martinhansdk/USB-epaper-thing/electronics/E-paper adapter board/E-paper adapter board.step

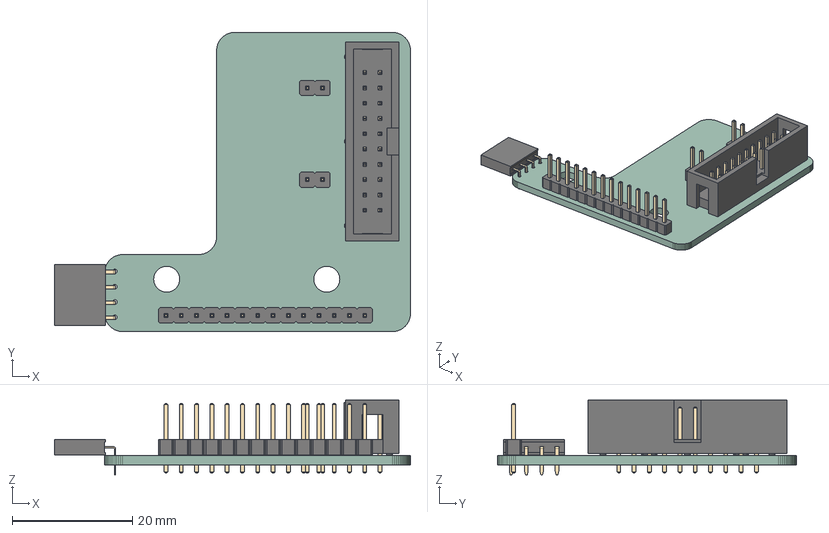
[picture p1: CAD file, 2023-12-19]
electronics/E-paper adapter board/E-paper adapter board.step
59.1 x 49.7 x 12.4 mm
_autosave-E-paper adapter board PCB
