martinhansdk/USB-epaper-thing/electronics/USB E-Paper thing/USB E-Paper thing.kicad_pcb

## KiCad design electronics/USB E-Paper thing/USB E-Paper thing.kicad_pcb (2023-12-19)

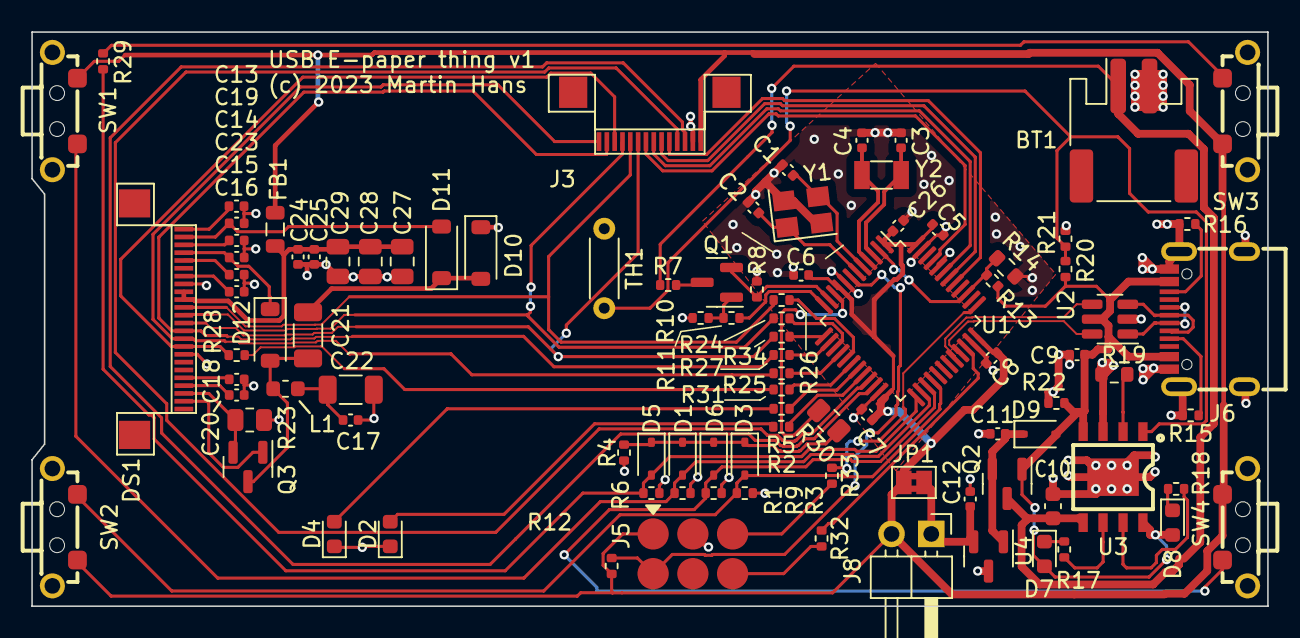
[picture p2: board USB E-Paper thing.kicad_pcb from above]

Board: 2 copper layers, 79.0 x 36.7 mm, 98 parts (0 on the bottom side), 76 nets.

Parts:
BT1: Battery_Cell; JST_PH_S2B-PH-SM4-TB_1x02-1MP_P2.00mm_Horizontal
C1, C2: 20pF; C_0402_1005Metric
C3, C4: 12p; C_0402_1005Metric
C5, C6, C7, C9, C25, C26: 100n; C_0402_1005Metric
C8, C11, C12: 1u; C_0402_1005Metric
C10: 10u; C_0603_1608Metric
C13, C24: 1u/6V; C_0402_1005Metric
C14, C15, C16, C17, C18, C19, C20, C23: 1u/25V; C_0402_1005Metric
C21: 4.7u/50V; C_1206_3216Metric
C22: 10u/50V; C_1206_3216Metric
C27, C28, C29: 47u/6V; C_0805_2012Metric
D1, D3, D5, D6, D9: 1N5819WS; D_SOD-323
D2: BLUE; LED_0603_1608Metric
D4: YELLOW; LED_0603_1608Metric
D7: GREEN; LED_0603_1608Metric
D8: RED; LED_0603_1608Metric
D10, D11, D12: B5819W; D_SOD-123
DS1: E-PAPER; CONN_FPC_24_AFC24-S24FIA-00
FB1: FerriteBead; L_0805_2012Metric
J3: EXTRA2; FPC_14
J5: SWD; Spring_loaded_connector_land_pattern_02x03
J6: USB 2.0 right angle; USB-C-SMD_G-SWITCH_GT-USB-7010ASV
J8: POWER_MEASUREMENT; PinHeader_1x02_P2.54mm_Horizontal
JP1: SolderJumper_2_Bridged; SolderJumper-2_P1.3mm_Bridged2Bar_Pad1.0x1.5mm
L1: 47uH; L_0603_1608Metric
Q1, Q3: AO3400A; SOT-23
Q2: AO3401A; SOT-23
R1, R3, R4, R6, R7, R8, R9, R10, R12: 10k; R_0402_1005Metric
R2, R24, R25, R26, R27, R28, R32, R33, R34: 33; R_0402_1005Metric
R5: 50; R_0402_1005Metric
R11: 10; R_0402_1005Metric
R13: 33k; R_0402_1005Metric
R14: 82k; R_0603_1608Metric
R15, R16, R20: 5k1; R_0402_1005Metric
R17, R18: 1k; R_0402_1005Metric
R19: 18k; R_0603_1608Metric
R21, R22: 100k; R_0402_1005Metric
R23: 4.7; R_0805_2012Metric
R29, R31: 0R; R_0402_1005Metric
R30: 0R; R_0805_2012Metric
SW1: BUTTON0; KEY-TH_K2-1112SW-AXXW-XX
SW2: BUTTON1; KEY-TH_K2-1112SW-AXXW-XX
SW3: BUTTON2; KEY-TH_K2-1112SW-AXXW-XX
SW4: BUTTON3; KEY-TH_K2-1112SW-AXXW-XX
TH1: Thermistor_NTC; R_Axial_DIN0204_L3.6mm_D1.6mm_P5.08mm_Horizontal
U1: STM32L151C8TxA; LQFP-48_7x7mm_P0.5mm
U2: USBLC6-2SC6; SOT-23-6
U3: TP4056; ESOP-8_L4.9-W3.9-P1.27-LS6.0-BL-EP
U4: ME6216 3V0; SOT-23
Y1: 12 MHz; Crystal_SMD_3225-4Pin_3.2x2.5mm
Y2: 32.768 kHz; Crystal_SMD_3215-2Pin_3.2x1.5mm

Connections:
+3V0: C5.1, C6.1, C7.1, C8.1, C26.1, FB1.2, J3.1, J5.1, J8.2, JP1.2 (B), R12.1, SW1.1, SW2.2, SW3.1, SW4.2, U1.1 (VLCD), U1.9 (VDDA), U1.24 (VDD), U1.36 (VDD), U1.48 (VDD)
+BATT: BT1.1 (+), C10.1, Q2.3 (D), R7.1, U3.5 (BAT)
/BUSY: R28.2, R31.2
/BUSY_DBG: DS1.9 (BUSY), J3.12, R28.1
/BUTTON0: D1.2 (A), R1.1, SW1.2, U1.26 (PB13)
/BUTTON1: D3.2 (A), R3.1, SW2.1, U1.28 (PB15)
/BUTTON2: D5.2 (A), R6.1, R29.1, U1.25 (PB12)
/BUTTON3: D6.2 (A), R9.1, SW4.1, U1.27 (PB14)
/D/~C: DS1.11 (D/C#), J3.13, R27.2
/E-Ink display/GDR: DS1.2 (GDR), Q3.1 (G)
/E-Ink display/PREVGH: C23.1, D12.1 (K), DS1.21 (PREVGH)
/E-Ink display/PREVGL: C19.1, D11.2 (A), DS1.23 (PREVGL)
/E-Ink display/RESE: DS1.3 (RESE), Q3.2 (S), R23.2
/E-Ink display/VCC: C24.1, C25.1, C27.1, C28.1, C29.1, DS1.15 (VDDIO), DS1.16 (VCI), FB1.1
/E-Ink display/VCI: C17.1, C22.1, L1.2
/E-Ink display/VCOM: C13.1, DS1.24 (VCOM)
/E-Ink display/VDD: C16.1, DS1.18 (VDD)
/E-Ink display/VGH: C18.1, DS1.5 (VGH)
/E-Ink display/VGL: C20.1, DS1.4 (VGL)
/E-Ink display/VSH: C15.1, DS1.20 (VSH)
/E-Ink display/VSL: C14.1, DS1.22 (VSL)
/LED0: R5.1, U1.19 (PB1)
/LED1: R2.1, U1.20 (PB2)
/MOSI: DS1.14 (D1), J3.10, R26.2
/NRST: J5.6, R12.2, U1.7 (NRST)
/PB5: J3.5, U1.41 (PB5)
/PB6: J3.6, U1.42 (PB6)
/PB7: J3.7, U1.43 (PB7)
/PB8: J3.8, U1.45 (PB8)
/Power/CC1: J6.A5 (CC1), R15.1
/Power/CC2: J6.B5 (CC2), R16.1
/Power/USB_IN_D+: J6.A6 (D+), J6.B6 (D+), U2.1 (I/O1)
/Power/USB_IN_D-: J6.A7 (D-), J6.B7 (D-), U2.3 (I/O2)
/SCLK: DS1.13 (D0), J3.11, R24.2
/SERIAL_RX: J3.3, U1.22 (PB11)
/SERIAL_TX: J3.4, U1.21 (PB10)
/SWDCLK: J5.3, R33.2
/SWDIO: J5.4, R32.2
/USB_D+: U1.33 (PA12), U2.6 (I/O1)
/USB_D-: U1.32 (PA11), U2.4 (I/O2)
/VBAT_MEAS: Q1.2 (S), R8.1, U1.11 (PA1)
/VBAT_MEAS_EN: R11.2, U1.12 (PA2)
/VBUS: C9.1, D7.2 (A), D8.2 (A), D9.2 (A), J6.A4 (VBUS), J6.A9 (VBUS), J6.B4 (VBUS), J6.B9 (VBUS), Q2.1 (G), R13.1, R20.1, R22.1, U2.5 (VBUS), U3.4 (VCC), U3.8 (CE)
/VBUS_PRESENT: R13.2, R14.1, U1.2 (PC13), U1.39 (PB3)
/WAKEUP: R30.1, U1.10 (PA0)
/~CS: DS1.12 (CS#), J3.9, R34.2
/~RES: DS1.10 (RES#), J3.14, R25.2
GND: BT1.2 (-), C1.2, C2.2, C3.2, C4.2, C5.2, C6.2, C7.2, C8.2, C9.2, C10.2, C11.2, C12.2, C13.2, C14.2, C15.2, C16.2, C17.2, C18.2, C19.2, C20.2, C22.2, C23.2, C24.2, C25.2, C26.2, C27.2, C28.2, C29.2, D2.1 (K), D4.1 (K), D10.1 (K), DS1.8 (BS1), DS1.17 (VSS), J3.2, J5.2, J6.A1 (GND), J6.A12 (GND), J6.B1 (GND), J6.B12 (GND), J6.S1 (SHIELD), R1.2, R3.2, R4.2, R6.2, R8.2, R9.2, R10.1, R14.2, R15.2, R16.2, R19.2, R21.2, R22.2, R23.1, TH1.1, U1.8 (VSSA), U1.23 (VSS), U1.35 (VSS), U1.44 (BOOT0), U1.47 (VSS), U2.2 (GND), U3.3 (GND), U3.9 (THERMAL), U4.3 (GND), Y1.2, Y1.4
unnamed: D1.1 (K), D3.1 (K), D5.1 (K), D6.1 (K), R4.1, R30.2
unnamed: D2.2 (A), R2.2
unnamed: D4.2 (A), R5.2
unnamed: D7.1 (K), R17.1
unnamed: D8.1 (K), R18.1
unnamed: C11.1, D9.1 (K), Q2.2 (S), U4.1 (IN)
unnamed: C21.2, D10.2 (A), D11.1 (K)
unnamed: C21.1, D12.2 (A), L1.1, Q3.3 (D)
unnamed: C12.1, J8.1, JP1.1 (A), U4.2 (OUT)
unnamed: Q1.3 (D), R7.2
unnamed: Q1.1 (G), R10.2, R11.1
unnamed: R29.2, SW3.2
unnamed: R34.1, U1.13 (PA3)
unnamed: R27.1, U1.14 (PA4)
unnamed: R24.1, U1.15 (PA5)
unnamed: R25.1, U1.16 (PA6)
unnamed: R26.1, U1.17 (PA7)
unnamed: R32.1, U1.34 (PA13)
unnamed: R33.1, U1.37 (PA14)
unnamed: R31.1, U1.18 (PB0)
unnamed: C3.1, U1.3 (PC14), Y2.2
unnamed: C4.1, U1.4 (PC15), Y2.1
unnamed: C1.1, U1.5 (PH0), Y1.3
unnamed: C2.1, U1.6 (PH1), Y1.1
unnamed: R19.1, U3.2 (PROG)
unnamed: R20.2, R21.1, TH1.2, U3.1 (TEMP)
unnamed: R18.2, U3.7 (~CHRG)
unnamed: R17.2, U3.6 (~STDBY)
