martinhansdk/USB-epaper-thing/electronics/E-paper adapter board/E-paper adapter board.kicad_pcb

## KiCad design electronics/E-paper adapter board/E-paper adapter board.kicad_pcb (2023-12-11)

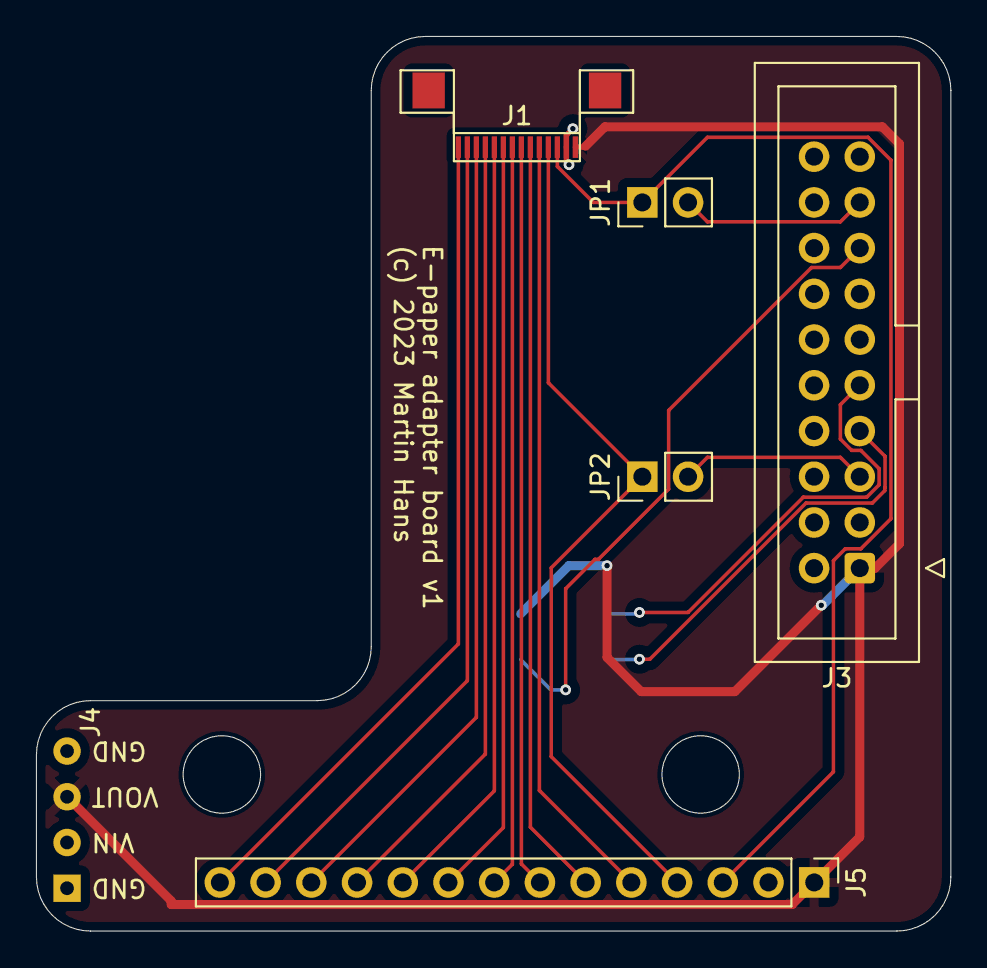
[picture p3: board E-paper adapter board.kicad_pcb from above]

Board: 2 copper layers, 50.8 x 49.7 mm, 9 parts (1 on the bottom side), 19 nets.

Parts:
H1, H2: MountingHole; MountingHole_4.3mm_M4_DIN965
J1: EXTRA; FPC_14
J2: SWD; E-paper programming connector
J3: J-LINK; IDC-Header_2x10_P2.54mm_Vertical
J4: nRF-PPK2; nRF-PPK2_power
J5: DEBUG; PinHeader_1x14_P2.54mm_Vertical
JP1, JP2: Jumper_2_Bridged; PinHeader_1x02_P2.54mm_Vertical

Connections:
+3V0: J1.1, J2.1, J3.1, J4.3 (VOUT), J5.1
/BUSY: J1.12, J5.12
/D/~C: J1.13, J5.13
/MOSI: J1.10, J5.10
/NRST: J2.6, J3.15
/PB5: J1.5, J5.5
/PB6: J1.6, J5.6
/PB7: J1.7, J5.7
/PB8: J1.8, J5.8
/PG_UART_RXD: J3.5, JP2.2 (B)
/PG_UART_TXD: J3.17, JP1.2 (B)
/SCLK: J1.11, J5.11
/SERIAL_RX: J1.3, J5.3, JP1.1 (A)
/SERIAL_TX: J1.4, J5.4, JP2.1 (A)
/SWDCLK: J2.3, J3.9
/SWDIO: J2.4, J3.7
/~CS: J1.9, J5.9
/~RES: J1.14, J5.14
GND: J1.2, J2.2, J3.4, J3.6, J3.8, J3.10, J3.12, J4.1 (GND), J4.4 (GND), J5.2
