martinhansdk/USB-epaper-thing/(commit log)

2023-11-06 WIP commit
    [USB E-Paper thing.kicad_pcb, USB E-Paper thing.kicad_sch, e-ink display.kicad_sch, power.kicad_sch]
2023-12-03 Use single FPC connector for debug signals and downstream
    [USB E-Ink thing-CuBottom.gbr, USB E-Ink thing-CuTop.gbr, USB E-Ink thing-EdgeCuts.gbr, USB E-Ink thing-MaskBottom.gbr, USB E-Ink thing-MaskTop.gbr, USB E-Ink thing-NPTH.drl, USB E-Ink thing-PTH.drl, USB E-Ink thing-PasteBottom.gbr]
2023-12-04 Resistor calculations
    [power.kicad_sch]
2023-12-04 switch to JLCPCB version of USBC connect fp
    [USB E-Ink thing-CuBottom.gbr, USB E-Ink thing-CuTop.gbr, USB E-Ink thing-EdgeCuts.gbr, USB E-Ink thing-MaskBottom.gbr, USB E-Ink thing-MaskTop.gbr, USB E-Ink thing-NPTH.drl, USB E-Ink thing-PTH.drl, USB E-Ink thing-PasteBottom.gbr]
2023-12-05 Fix all DRC violations, fix 12 MHz crystal connections
    [USB E-Paper thing-CuBottom.gbr, USB E-Paper thing-CuTop.gbr, USB E-Paper thing-EdgeCuts.gbr, USB E-Paper thing-MaskBottom.gbr, USB E-Paper thing-MaskTop.gbr, USB E-Paper thing-NPTH.drl, USB E-Paper thing-PTH.drl, USB E-Paper thing-PasteBottom.gbr]
2023-12-05 move electronics project to subdir
    [USB E-Paper thing-CuBottom.gbr, USB E-Paper thing-CuTop.gbr, USB E-Paper thing-EdgeCuts.gbr, USB E-Paper thing-MaskBottom.gbr, USB E-Paper thing-MaskTop.gbr, USB E-Paper thing-NPTH.drl, USB E-Paper thing-PTH.drl, USB E-Paper thing-PasteBottom.gbr]
2023-12-06 add adapter board
    [E-paper adapter board-CuBottom.gbr, E-paper adapter board-CuTop.gbr, E-paper adapter board-EdgeCuts.gbr, E-paper adapter board-MaskBottom.gbr, E-paper adapter board-MaskTop.gbr, E-paper adapter board-NPTH.drl, E-paper adapter board-PTH.drl, E-paper adapter board-PasteBottom.gbr]
2023-12-11 fix TP4056 footprint
    [E-paper adapter board-CuBottom.gbr, E-paper adapter board-CuTop.gbr, E-paper adapter board-EdgeCuts.gbr, E-paper adapter board-MaskBottom.gbr, E-paper adapter board-MaskTop.gbr, E-paper adapter board-NPTH.drl, E-paper adapter board-PTH.drl, E-paper adapter board-PasteBottom.gbr]
2023-12-19 Add STEP files of the boards
    [E-paper adapter board.step, USB E-Paper thing.kicad_pcb]
2023-12-30 Added blink firmware for board bringup
2023-12-30 Use alternative pin names on STM32 symbol on schematic
    [USB E-Paper thing.kicad_sch]
2023-12-31 Working board definition based on STM32Duino's generic STM32L151C8T6 board
2023-12-31 Move board definition so they can be shared between platformio projects
