martinhansdk/USB-epaper-thing/(notices)

Notices in the files:
electronics/USB E-Paper thing/USB E-Paper thing.kicad_pcb:
(c) 2023 Martin Hans
